OpenZSD/LockerBox/pdf/doc_files/20170303_180526.png

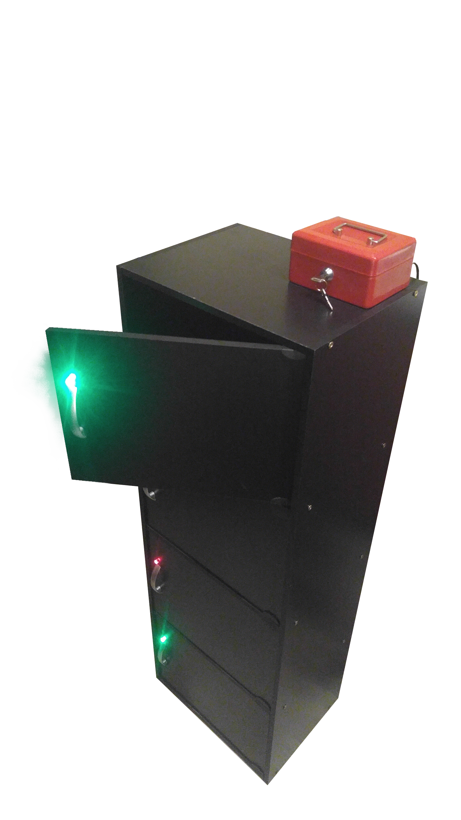
pdf/doc_files/20170303_180526.png
