OpenZSD/LockerBox/README.txt

Author: Jerry Z.

Contained are the arduino sketch (source code), circuit diagram and documentation for the locker system. [Files will be added as the project progresses]
