OpenZSD/LockerBox/pdf/doc_files/diode2.png

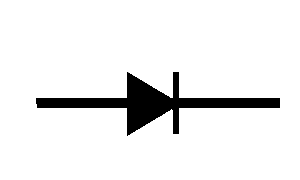
pdf/doc_files/diode2.png
