OpenZSD/LockerBox/pdf/doc_files/diode.png

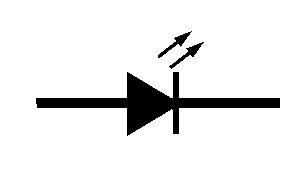
pdf/doc_files/diode.png
