OpenZSD/LockerBox/pdf/doc_files/inside.png

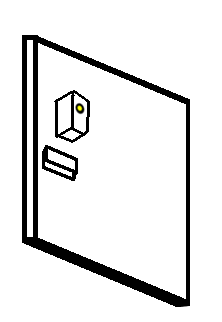
pdf/doc_files/inside.png
