OpenZSD/LockerBox/pdf/doc_files/outside.png

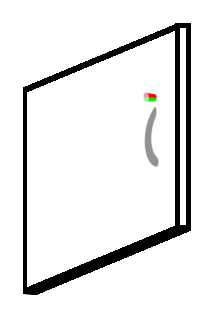
pdf/doc_files/outside.png
