OpenZSD/LockerBox/pdf/doc_files/res.png

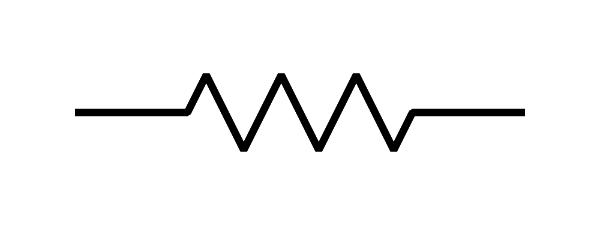
pdf/doc_files/res.png
